devhimoco/CatFountain/assets/Image001.jpg

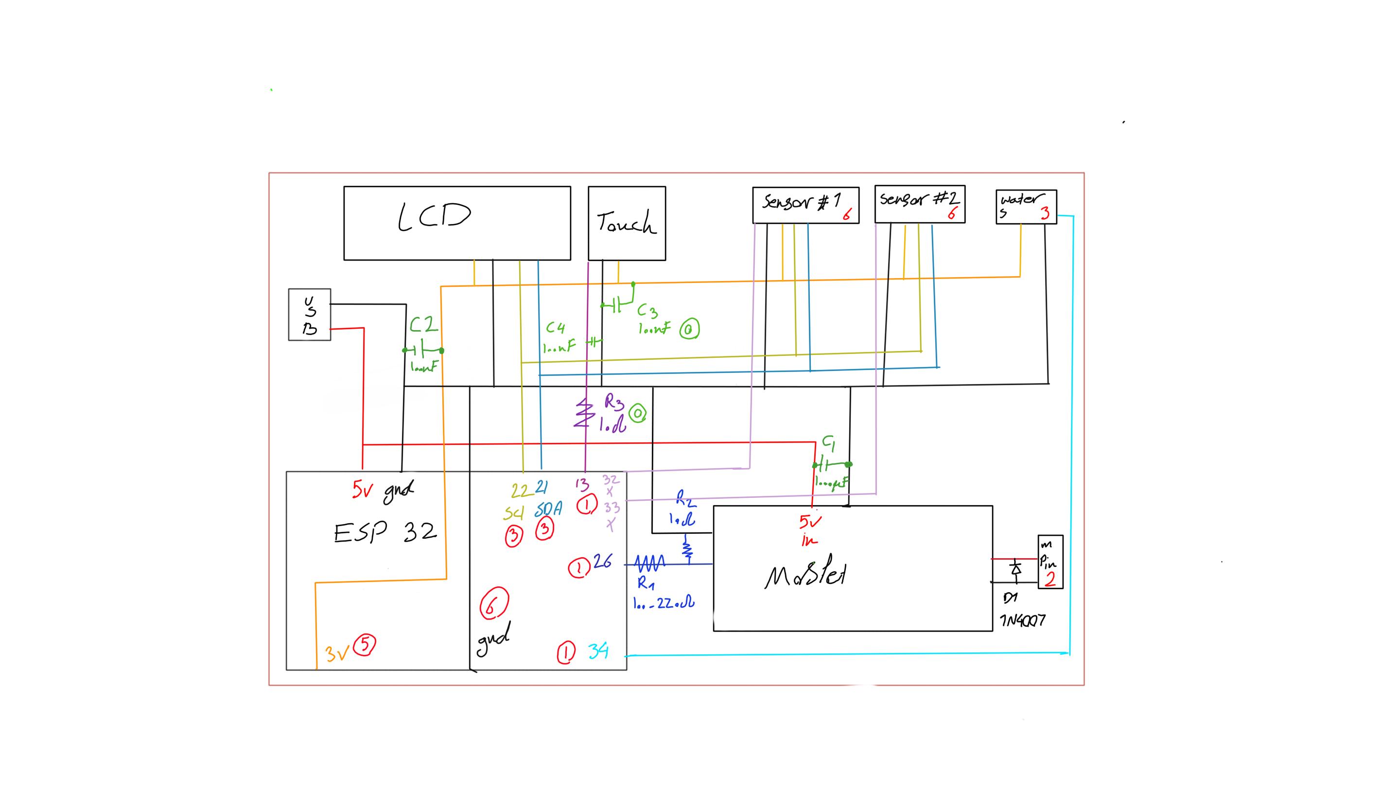
assets/Image001.jpg
