devhimoco/CatFountain/assets/Screenshot-2026-07-13-145037.png

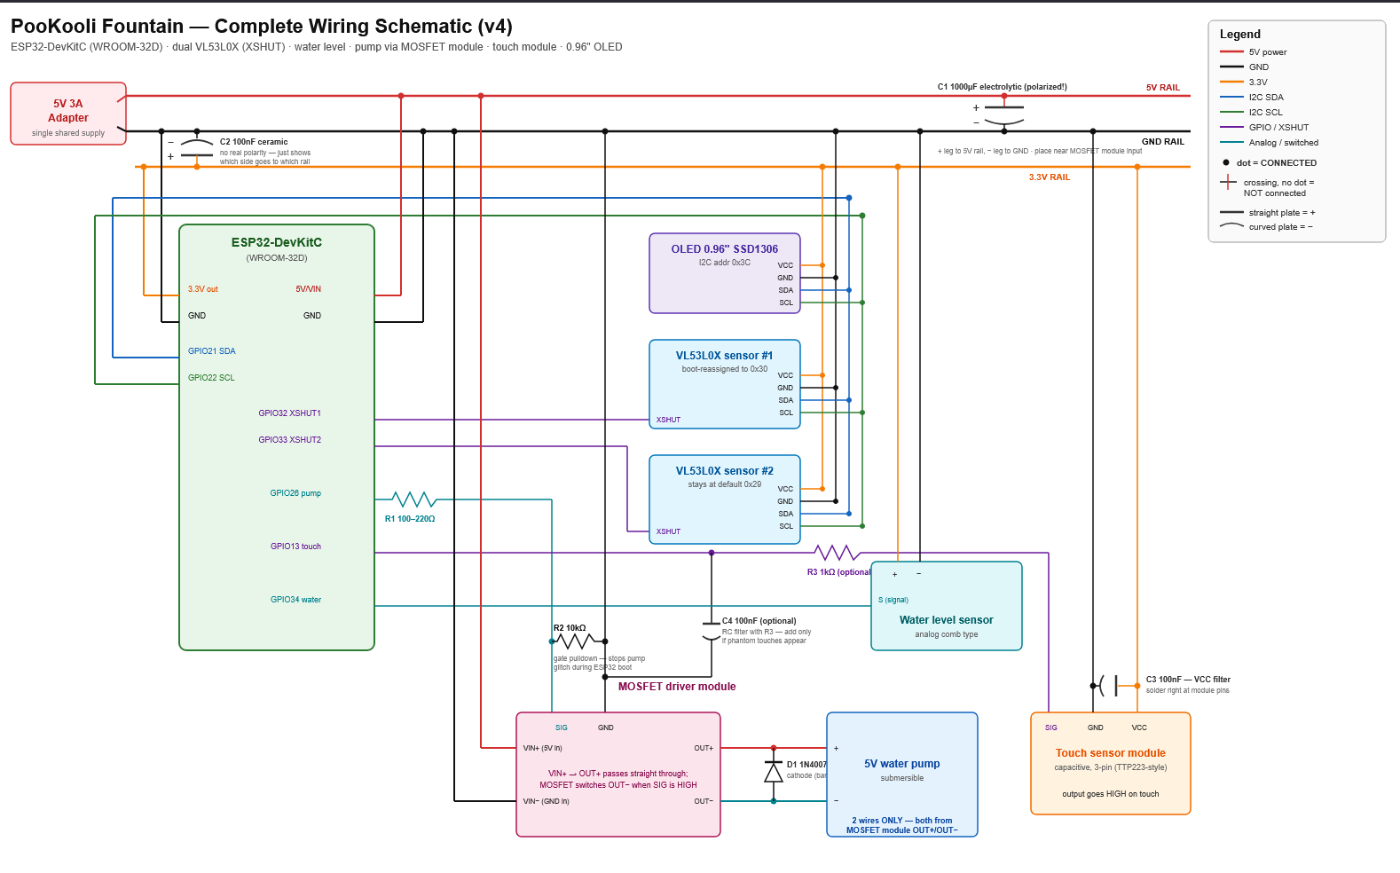
assets/Screenshot-2026-07-13-145037.png
