devhimoco/CatFountain/1-infrared/V07-WithPIC/V07-WithPIC.ino

/*
 ╔══════════════════════════════════════════════════════════╗
 ║     PooKooli Fountain — ESP32 NodeMCU-32  v4             ║
 ║                                                          ║
 ║  Changes from v3:                                        ║
 ║   ✓ Renamed to "PooKooli Fountain" everywhere            ║
 ║   ✓ Continuous mode: pump runs forever until stopped     ║
 ║     via app Stop button or physical touch button         ║
 ╚══════════════════════════════════════════════════════════╝

 ── INSTALL THESE LIBRARIES (Arduino Library Manager) ──────
   • Adafruit SSD1306   (by Adafruit)
   • Adafruit GFX       (by Adafruit)

 ── WIRING ─────────────────────────────────────────────────
  OLED 0.91" SSD1306 (I2C)
    VCC → 3.3V
    GND → GND
    SCL → GPIO 22
    SDA → GPIO 21

  Touch Sensor (red module)
    VCC → 3.3V  |  GND → GND  |  OUT → GPIO 4

  PIR Sensor HC-SR501
    VCC → 5V    |  GND → GND  |  OUT → GPIO 14

  Water Level Sensor HW-101
    VCC → 3.3V  |  GND → GND  |  DO  → GPIO 34
    (DO = digital output; LOW when submerged = water OK)

  Relay Module (Tongling JQC-3FF-S-Z — ACTIVE LOW blue board)
    VCC → Vin (5 V from USB)
    GND → GND
    IN  → GPIO 26
    COM → pump positive wire
    NO  → power-supply positive
    (pump negative → power-supply negative)
 ───────────────────────────────────────────────────────────
*/

#include <WiFi.h>
#include <WebServer.h>
#include <Preferences.h>
#include <Wire.h>
#include <Adafruit_GFX.h>
#include <Adafruit_SSD1306.h>

// ── USER CONFIG ────────────────────────────────────────────
const char* WIFI_SSID     = "HiMo 2G";
const char* WIFI_PASSWORD = "@HiMo9226#";

// GPIO
#define PIN_TOUCH        4
#define PIN_PIR         14
#define PIN_WATER_DO    34   // DO pin — INPUT_PULLUP; LOW = water present
#define PIN_RELAY       26

// Relay: most blue boards are ACTIVE LOW (LOW = coil ON = pump ON)
// If your pump runs backwards, flip this to false.
#define RELAY_ACTIVE_LOW  true

// Durations (seconds) — editable from web UI, saved to flash
#define DEFAULT_TOUCH_SEC   60
#define DEFAULT_PIR_SEC     60
#define DEFAULT_WIFI_SEC   120
#define MIN_SEC   5
#define MAX_SEC   600

// Debounce / lockout
#define TOUCH_DEBOUNCE_MS   500
#define PIR_LOCKOUT_MS     5000
#define EMPTY_BLINK_MS     3000   // how long to show "tank empty" error on OLED

// OLED
#define OLED_WIDTH  128
#define OLED_HEIGHT  32
#define OLED_ADDR   0x3C
#define OLED_RESET   -1

// ── GLOBALS ────────────────────────────────────────────────
WebServer    server(80);
Preferences  prefs;
Adafruit_SSD1306 oled(OLED_WIDTH, OLED_HEIGHT, &Wire, OLED_RESET);

unsigned long touchDurationMs = DEFAULT_TOUCH_SEC * 1000UL;
unsigned long pirDurationMs   = DEFAULT_PIR_SEC   * 1000UL;
unsigned long wifiDurationMs  = DEFAULT_WIFI_SEC  * 1000UL;

enum PumpSource { SRC_NONE, SRC_TOUCH, SRC_PIR, SRC_WIFI };

bool          pumpRunning    = false;
bool          pumpContinuous = false;   // true = run forever (no timer)
PumpSource    pumpSource     = SRC_NONE;
unsigned long pumpStartTime  = 0;
unsigned long pumpDuration   = 0;
bool          tankEmptyError = false;   // set when trigger fires but tank is empty
unsigned long emptyErrorTime = 0;       // when the error was set

unsigned long lastTouchTime  = 0;
unsigned long lastPirEndTime = 0;
unsigned long lastOledUpdate = 0;

// ── FLASH ──────────────────────────────────────────────────
void loadSettings() {
  prefs.begin("fountain", true);
  touchDurationMs = prefs.getULong("touch_ms", DEFAULT_TOUCH_SEC * 1000UL);
  pirDurationMs   = prefs.getULong("pir_ms",   DEFAULT_PIR_SEC   * 1000UL);
  wifiDurationMs  = prefs.getULong("wifi_ms",  DEFAULT_WIFI_SEC  * 1000UL);
  prefs.end();
}
void saveSettings() {
  prefs.begin("fountain", false);
  prefs.putULong("touch_ms", touchDurationMs);
  prefs.putULong("pir_ms",   pirDurationMs);
  prefs.putULong("wifi_ms",  wifiDurationMs);
  prefs.end();
}

// ── WATER SENSOR ───────────────────────────────────────────
// HW-101 DO: LOW when probes submerged (water present)
//            HIGH when dry
// Your sensor is inverted vs the label, so:
//   digitalRead LOW  → has water   ✓
//   digitalRead HIGH → empty       ✓
bool hasWater() {
  // Use INPUT_PULLUP so floating pin reads HIGH (safe = empty)
  return digitalRead(PIN_WATER_DO) == LOW;
}

// ── RELAY / PUMP ───────────────────────────────────────────
void pumpON() {
  digitalWrite(PIN_RELAY, RELAY_ACTIVE_LOW ? LOW : HIGH);
}
void pumpOFF() {
  digitalWrite(PIN_RELAY, RELAY_ACTIVE_LOW ? HIGH : LOW);
  pumpRunning    = false;
  pumpContinuous = false;
  pumpSource     = SRC_NONE;
}
void startPump(PumpSource src, unsigned long dur) {
  tankEmptyError = false;
  pumpRunning    = true;
  pumpContinuous = false;
  pumpSource     = src;
  pumpStartTime  = millis();
  pumpDuration   = dur;
  pumpON();
  Serial.printf("[Pump] ON  src=%d  dur=%lus\n", src, dur / 1000);
}
void startPumpForever(PumpSource src) {
  tankEmptyError = false;
  pumpRunning    = true;
  pumpContinuous = true;
  pumpSource     = src;
  pumpStartTime  = millis();
  pumpDuration   = 0;
  pumpON();
  Serial.printf("[Pump] ON  src=%d  CONTINUOUS\n", src);
}
void triggerBlocked(PumpSource src) {
  tankEmptyError = true;
  emptyErrorTime = millis();
  if (src == SRC_NONE)
    Serial.println("[Pump] STOPPED — tank ran empty during run");
  else
    Serial.printf("[Pump] BLOCKED src=%d — tank empty\n", src);
}

// ── OLED DISPLAY ───────────────────────────────────────────
// Called regularly from loop(); keeps display in sync with state.
void updateOled() {
  oled.clearDisplay();
  oled.setTextColor(SSD1306_WHITE);
  oled.setTextWrap(false);   // ← disables auto-wrap; text is clipped instead of wrapping

  // ── ERROR: tank empty ──────────────────────────────────
  if (tankEmptyError) {
    oled.setTextSize(1);
    oled.setCursor(0,  0); oled.print(F("!! TANK EMPTY !!"));
    oled.setCursor(0, 12); oled.print(F("Please refill"));
    oled.setCursor(0, 24); oled.print(F("water reservoir"));
    oled.display();
    return;
  }

  // ── PUMP RUNNING ───────────────────────────────────────
  if (pumpRunning) {
    oled.setTextSize(1);

    // Row 0 — source label  (max 21 chars)
    const char* srcLabel =
      (pumpSource == SRC_TOUCH) ? "Pump ON-Touch" :
      (pumpSource == SRC_PIR)   ? "Pump ON-PIR"   :
                                  "Pump ON-App";
    oled.setCursor(0, 0);
    oled.print(srcLabel);

    if (pumpContinuous) {
      // Row 1 — elapsed  e.g. "~~ 04:32 ~~"
      unsigned long elSec = (millis() - pumpStartTime) / 1000;
      char buf[14];
      snprintf(buf, sizeof(buf), "~~ %02lu:%02lu ~~",
               elSec / 60, elSec % 60);
      oled.setCursor(16, 13);
      oled.print(buf);
      // Row 2
      oled.setCursor(8, 24);
      oled.print(F("CONTINUOUS MODE"));

    } else {
      // Row 1+2 — big countdown centred
      unsigned long elapsed = millis() - pumpStartTime;
      unsigned long remain  = (elapsed >= pumpDuration) ? 0
                                                        : (pumpDuration - elapsed);
      unsigned int m = (remain / 1000) / 60;
      unsigned int s = (remain / 1000) % 60;
      char buf[6];
      snprintf(buf, sizeof(buf), "%02d:%02d", m, s);
      oled.setTextSize(2);
      // Each char is 12 px wide at size 2; centre in 128 px
      int x = (OLED_WIDTH - (int)strlen(buf) * 12) / 2;
      oled.setCursor(max(0, x), 12);
      oled.print(buf);
    }

    oled.display();
    return;
  }

  // ── IDLE ───────────────────────────────────────────────
  bool water = hasWater();
  oled.setTextSize(1);

  // Row 0 — device name  (17 chars, fits fine)
  oled.setCursor(0, 0);
  oled.print(F("PooKooli Fountain"));

  // Row 1 — IP address or short error  (max 21 chars)
  oled.setCursor(0, 11);
  if (WiFi.status() == WL_CONNECTED) {
    // IP like "192.168.xxx.xxx" = 15 chars max
    oled.print(WiFi.localIP().toString());
  } else {
    oled.print(F("No WiFi"));
  }

  // Row 2 — water status  (max 21 chars)
  oled.setCursor(0, 22);
  if (water) {
    oled.print(F("Water OK - Ready"));
  } else {
    if ((millis() / 600) % 2 == 0)
      oled.print(F("!! TANK EMPTY !!"));
    else
      oled.print(F("Add water please"));
  }

  oled.display();
}

// ── JSON ───────────────────────────────────────────────────
String srcStr() {
  if (pumpSource == SRC_TOUCH) return "TOUCH";
  if (pumpSource == SRC_PIR)   return "PIR";
  if (pumpSource == SRC_WIFI)  return "WIFI";
  return "NONE";
}

String buildStatusJson() {
  unsigned long elapsed = pumpRunning ? (millis() - pumpStartTime) : 0;
  bool water = hasWater();
  String j = "{";
  j += "\"running\":"       + String(pumpRunning     ? "true" : "false") + ",";
  j += "\"continuous\":"    + String(pumpContinuous  ? "true" : "false") + ",";
  j += "\"empty_error\":"   + String(tankEmptyError  ? "true" : "false") + ",";
  j += "\"source\":\""      + srcStr() + "\",";
  j += "\"water\":"         + String(water           ? "true" : "false") + ",";
  j += "\"elapsed_ms\":"    + String(elapsed) + ",";
  j += "\"duration_ms\":"   + String(pumpDuration) + ",";
  j += "\"touch_sec\":"     + String(touchDurationMs / 1000) + ",";
  j += "\"pir_sec\":"       + String(pirDurationMs   / 1000) + ",";
  j += "\"wifi_sec\":"      + String(wifiDurationMs  / 1000);
  j += "}";
  return j;
}

// ── HTML ───────────────────────────────────────────────────
const char INDEX_HTML[] PROGMEM = R"rawliteral(
<!DOCTYPE html>
<html lang="en">
<head>
<meta charset="UTF-8">
<meta name="viewport" content="width=device-width,initial-scale=1,maximum-scale=1">
<title>PooKooli Fountain</title>
<meta name="mobile-web-app-capable" content="yes">
<meta name="apple-mobile-web-app-capable" content="yes">
<meta name="apple-mobile-web-app-status-bar-style" content="black-translucent">
<meta name="apple-mobile-web-app-title" content="PooKooli">
<meta name="theme-color" content="#07090f">
<link rel="apple-touch-icon" href="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">
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
