devhimoco/CatFountain/(commit log)

2026-07-22 Publish the complete CatFountain project archive
    Three generations of a sensor-driven ESP32 cat water fountain, 57 sketches,
    from the first BLE/infrared prototype through to PooKooli Fountain X V2.4.
    Structure
    - 1-infrared/ Gen V, 18 sketches: IR/PIR + relay, BLE -> WiFi -> MOSFET
    - 2-ultrasonic/ Gen VI, 3 sketches: HC-SR04
    - 3-laser/ Gen X, 36 sketches: 2x VL53L0X (ModuleTest/Beta/Alfa-X)
    - stable/ The build to flash (X V2.4)
    - assets/ docs/ Schematic, photos, diagrams, setup and hardware guides
    Documentation added
    - README.md with the full evolution story and why each sensor generation ended
    - CHANGELOG.md covering every version, what changed and why
    - docs/SETUP.md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
2026-08-09 Add 8 new Alfa-X versions (V36-V43), promote V2.7 to stable
    Nine sketches written since publication: V36-V39 independently
    re-verify the V2.4 crash fixes one at a time (landing back at V35
    byte-for-byte); V41 adds a BLE iTag remote; V42/V43 fix false
    "tank empty" trips with median-filtered, recalibrated water
    readings. V43 (X V2.7) is promoted to stable/ alongside V34/V35.
    A duplicate checkpoint of V35 (V40) is excluded via .gitignore, same
    as the existing Beta duplicates. The standalone
    PooKooli-Fountain-X-V2.4 repo (what's actually flashed on the
    device) stays a separate repo, cross-linked rather than copied in.
    Docs updated throughout: README, CHANGELOG, VERSION-MANIFEST, and
    the per-fo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
    [V36Alfa-X-V2.4.1-FRestartDuring.ino, V37AlfaX-V2.4.2-FFalseTrigger.ino, V38AlfaX-V2.4.3-FirstTrySchedule.ino, V39AlfaX-V2.4.4-AllFuncFix.ino, V41AlfaX-V2.5-Debug-AddBLRemoteLatest.ino, V42AlfaX-V2.6-Debug-ERRDntShow.ino, V43AlfaX-V2.7-Debug-WaterLevelFix.ino, iTag-BLE-Test-2.ino]
